martinprest/Psion2-Datapak-Rampak-reader-writer/Psion2_closed_thumb.jpg

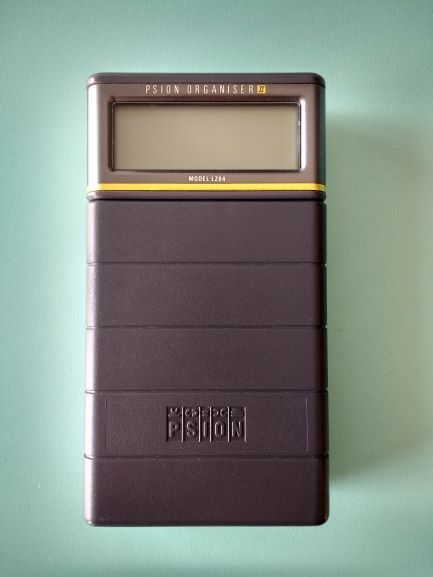
Psion2_closed_thumb.jpg
