martinprest/Psion2-Datapak-Rampak-reader-writer/Psion2_datapak_read_write_schematic.PNG

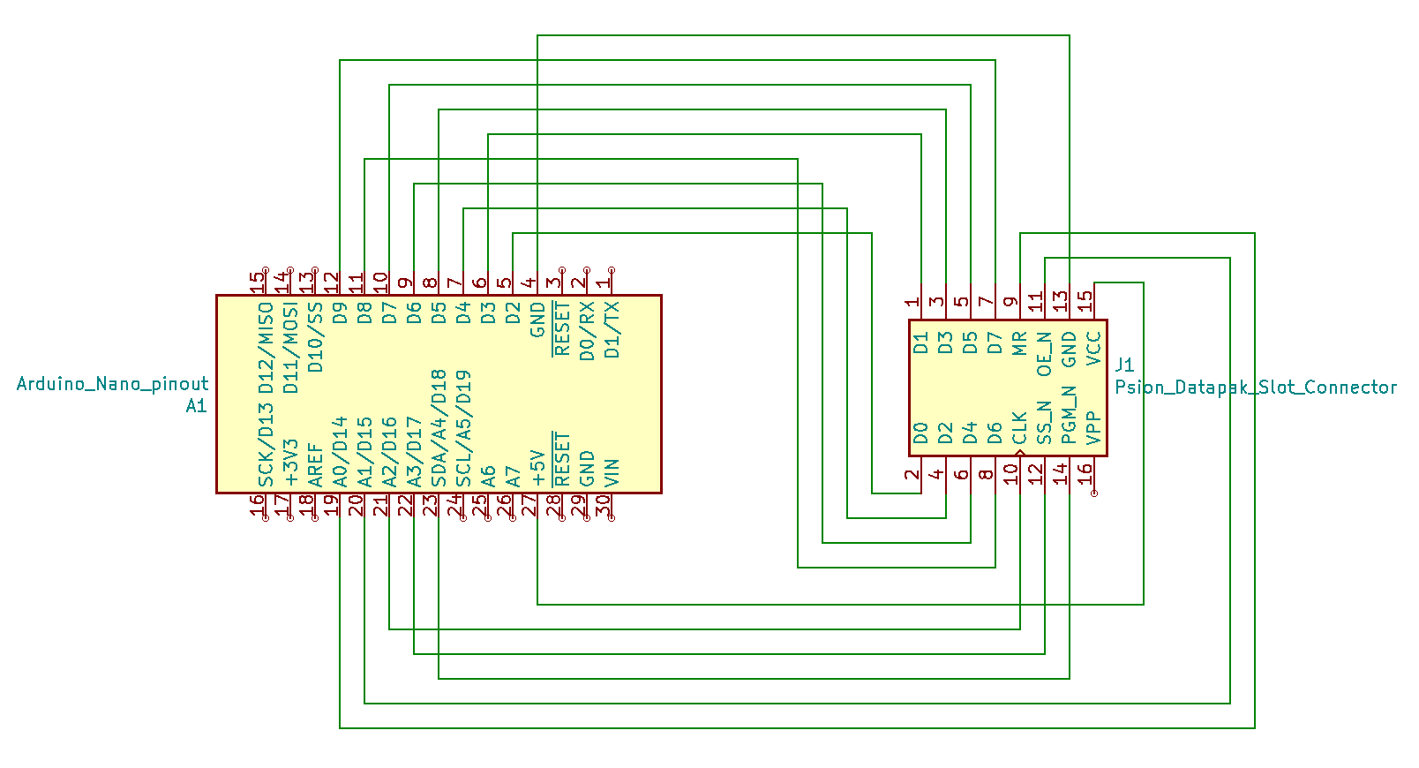
Psion2_datapak_read_write_schematic.PNG
