martinprest/Psion2-Datapak-Rampak-reader-writer/PC_Psion2_datapak_read_write_v1_3_1.py

0
# -*- coding: utf-8 -*-
"""
-------------------------------------------------------------------------
Datapak/Rampak Reader/Writer for Psion Organiser II
-------------------------------------------------------------------------
created by Martin Prest 2021

https://github.com/martinprest/Psion2-Datapak-Rampak-reader-writer

https://hackaday.io/project/176677-psion-ii-datapak-and-rampak-readerwriter

Uses linear or paged addressing, choose with paged_addr boolean variable below
packs that use segmented addressing are not supported
segmented addressing requires sending a segment address to the pack first

max read size is 64k bytes - could be increased, but packs larger than this generally use segmented addressing

v1.0 -  reads Datapaks and Rampaks, writes to Rampaks
works with: Arduino_Psion2_datapak_read-write_v1_0.ino on Arduino

v1.1 - added option for datapak write mode
works with: Arduino_Psion2_datapak_read-write_v1_1.ino on Arduino

v1.2 - Feb 2022 - added set_write_protect, update_checksum and fixedReadSize

v1.3 - Nov 2022 - added sizing and blank check using code from Matt Callow https://github.com/mattcallow/psion_pak_reader

v1.3.1 - Jan 2023 - bug fix for bootable pack types


"""

import keyboard as kb
import serial # uses pyserial
import time
import os

# set SerialPort and BaudRate values that work for your PC !! 

SerialPort = 'COM3' # Windows type port name, could be COM4 etc.
# SerialPort = '/dev/ttyUSB0' # Linux type port name, could be ttyUSB1 etc.

#BaudRate = 9600
# BaudRate = 19200
#BaudRate = 57600
BaudRate = 115200 # must match Arduino value

# numFFchk = 3 # must be same as Arduino program, to check for end of pack during read, if set_fixed_size = False

set_Rampak_ID = False # if false, leaves ID byte as it is in OPK file
# set_Rampak_ID = True # if true, modifies ID byte to set pack as a rampak
set_paged = False # if False, ID byte not modified
# set_paged = True # if True, modifies ID byte to set paged addressing
set_write_protect = False # if False, ID byte not modified
# set_write_protect = True # if True, modifies ID byte to set -write protect

update_checksum = False # if False uses checksum from OPK file
# update_checksum = True # if True, updates checksum to calculated one

read_fixed_size = False
# read_fixed_size = True
# read_pack_size = 0x7e9b
# read_pack_size = 0x0100

set_pack_size = False # if false, don't change pack size written to pack
# set_pack_size = True
#pack_size_out = 1 # 1*8 = 8 kB
#pack_size_out = 2 # 2*8 = 16 kB
pack_size_out = 4 # 4*8 = 32 kB

# infile = "rampak_colours.opk"
# infile = "comms42.opk"
infile = "testpak.opk"

print("Input filename:",infile)
f_size = os.path.getsize(infile)
print(f'(PC) File size is: {f_size} bytes, 0x{f_size:06x} bytes')

# outfile = "linear_datapak_blank_test_7e9b.opk"
outfile = "test.opk"
# outfile = "comms_linear_test.opk"

print("Output filename:",outfile)
f_out_open = False

def WritePak():
    print("(PC) Write")
    read_file = False
    f_in = open(infile,'rb')
    data = f_in.read(3) # Should be "OPK"
    header = data.decode()
    print(f'(PC) OPK header: "{header:s}"')
    if header != "OPK":
        print("Error! Not an OPK file!")
        return
    size_hh = ord(f_in.read(1))
    size_h = ord(f_in.read(1))
    size_l = ord(f_in.read(1))
    
    f_in_size = (size_hh << 16) + (size_h << 8) + size_l # shift size_h left 16 bits, size_h left 8 bits
    print(f'(PC) Pack image size: size_hh: 0x{size_hh:02x}, size_h: 0x{size_h:02x}, size_l: 0x{size_l:02x}, size: 0x{f_in_size:06x}')
        
    if f_in_size > 0xFFFF:
        print("(PC) File too big to write!")
        return
        
    size_h = (f_in_size & 0xFF00) >> 8 # high byte, shift right 8 bits, top byte (size_hh) removed, so max size is 64k!!
    size_l = f_in_size & 0xFF # lowest 8 bits, AND with 0xFF
    
    time.sleep(0.2) # 0.2 second delay for Arduino to send messages
    while ser.inWaiting(): # read & print lines from Arduino until none left
        line_in = ser.readline() 
        print("(PC) Empty buffer:", line_in.decode(), end='') # decode from bytes
    
    ser.write("XXWrite".encode()) # encode to bytes - tells Arduino that following bytes are for write to datapak
    ser.write(bytes([size_h])) # send high byte
    ser.write(bytes([size_l])) # send low byte
    
    print(f'(PC) size_h: 0x{size_h:02x}, size_l: 0x{size_l:02x}')
    
    read_file = True
    addr = 0
    data = []
    
    while read_file: # read file data to write to datapak
        dat_out = f_in.read(1) # read from file - initially must be first byte after header
        n = ord(dat_out)
        
        if addr <= 9: # first 10 bytes (0-9) stored for checksum
            
            # bytes to be modified:
            if addr == 0:
                if set_Rampak_ID == True:            
                    n = n & 0b11111101 # clear bit 1 - rampak
                if set_paged == True:
                    n = n | 0b100 # set bit 2 - Paged
                if set_write_protect == True:
                    n = n & 0b11110111 # clear bit 3 - write_protect
                print(f'0: ID byte: {n:02x}')
            if addr == 1:
                if set_pack_size == True:
                    print(f'1: Pack size was: {n*8:d} kB, now is: {pack_size_out*8:d} kB')
                    n = pack_size_out
                else:
                    print(f'1: Pack size is: {n*8:d} kB')
     
            # non-modified bytes: - now includes both types of header - untested !!
            
            if addr >= 2 and addr <= 7:
                if (data[0] & 0x10) != 0x10: # bootable pack
                    bootable_header = {2:{'txt':'code type',0:'software',1:'hardware'},
                                       3:{'txt':'id',0xc0:'RS232',0xbf:'bar code reader',0xbe:'swipe card reader',0x0a:'concise oxford spelling checker'},
                                       4:{'txt':'version (binary coded decimal: 0xnm for version n.m'},
                                       5:{'txt':'priority (can be same as id)'},
                                       6:{'txt':'boot code pack address (high)'},
                                       7:{'txt':'boot code pack address (low)'}}
                    if addr >= 2 and addr <= 3:
                        try:
                            print(f'{addr:d}: {bootable_header[addr]["txt"]}: {bootable_header[addr][n]}')
                        except:
                            print(f'{addr:d}: {bootable_header[addr]["txt"]}: unknown')
                    if addr >= 4:
                        print(f'{addr:d}: {bootable_header[addr]["txt"]}: 0x{n:02x}')
                    if addr == 7:
                        print(f'boot code pack address: 0x{data[6]:02x}{n:02x}')
                                   
                else: # standard pack
                    standard_header = {2:['Year at time of sizing was {:d}','n+1900'],
                                       3:['Month at time of sizing was {:d}','n+1'],
                                       4:['Day at time of sizing was {:d}','n+1'],
                                       5:['Hour at time of sizing was {:d}','n'],
                                       6:['Free Running Counter (High) at time of sizing was 0x{:02x}','n'],
                                       7:['Free Running Counter (Low) at time of sizing was 0x{:02x}','n']}
    
                    print(f'{addr:d}:',standard_header[addr][0].format(eval(standard_header[addr][1])))
                    
                    if addr == 6: FRH = n
                    if addr == 7:
                        FRL = n
                        FRCT = (FRH<<8) + FRL
                        print(f"Free Running Counter (Total) at time of sizing was {FRCT:d} 0x{FRCT:04x}")
                
            data.append(n) # store bytes for checksum, must include modified bytes
                  
            # checksum bytes: 
            if update_checksum == True: # update checksum if True
                if addr == 8:
                    print(f'Checksum:')
                    CHKSUM = (data[0]<<8) + data[1] + (data[2]<<8) + data[3] + (data[4]<<8) + data[5] + (data[6]<<8) + data[7]
                    chk_h = (CHKSUM & 0xFF00) >> 8 # mask for high byte
                    chk_l = CHKSUM & 0xFF # mask for low byte            
                    print(f'8: chk_h = 0x{chk_h:02x}')
                    print(f'9: chk_l = 0x{chk_l:02x}')
                    CHKSUM = CHKSUM & 0xFFFF # mask for 16 bits
                    print(f'Checksum (calculated) is: {CHKSUM:d} 0x{CHKSUM:04x}')
                    n = chk_h
                if addr == 9:
                    n = chk_l
            
        dat_out = bytes([n])
        ser.write(dat_out)
        t = time.time()
        while not (ser.inWaiting() > 0): # If no data, wait and check for timeout
            if time.time()-t > 1: # 1 s timeout
                read_file = False
                print("(PC) Timeout!")
        dat_in = ser.read(1) # read check byte back from Arduino
        n = ord(dat_in) # convert to number
        if 31 < n < 127: # if printable character
            n2 = n
        else: # else replace non-printable character
            n2 = 46 # character "."
        if addr >= 8:
            print(f'{addr:04x} {n:02x} {chr(n2):s}  ', end='')
        if dat_in != dat_out:
            print("(PC) Write data not verified by Arduino!")
            read_file = False
        addr += 1
        if addr >8 and addr % 0x08 == 0: # if remainder of addr div 8 is zero, newline
            print("") # newline
        if addr > f_in_size:
            read_file = False
            print("") # newline at end of file
    f_in.close()
    
def ReadPak():
    with open(outfile,'wb') as f_out: # open file for output
        f_out.write("OPK".encode())
        f_out.write(bytes(3)) # write 3 zero bytes for size, written later
        # write_file = True
        addr = 0
        read_size = [0,0,0];
        for i in range(3):
            n = ser.read(1) # read 3 bytes for pack size
            read_size[i] = ord(n) 
            # print(n, read_size)
        rd_size = (read_size[0]<<16) + (read_size[1]<<8) + (read_size[2])
        print(f'Read size: {rd_size:06x}')
        # while write_file == True:
        while True:
            # if ser.inWaiting():
            dat = ser.read(1) # read 1 value
            if dat == bytes(): # no byte from read!
                print('\n(PC) Timeout! No byte from Arduino')
                break
            ser.write(dat) # echo back to Arduino for verify
            # ser.write(bytes([0xFF])) // write a single byte of value 0xFF
            n = ord(dat) # convert char or b'\xff' hex byte to value
            if 31 < n < 127:
                n2 = n
            else:
                n2 = 46 # character "." for non-printable character
            print(f'{addr:04x} {n:02x} {chr(n2):s}  ', end='')
            f_out.write(dat) # write it to file
            if read_fixed_size == True:
                if addr >= read_pack_size or addr >= rd_size: # read_pack_size can't be bigger than pack
                    break
            elif addr >= rd_size:
                    break
            addr += 1
            if addr % 8 == 0: # if remainder of addr div 8 is zero, newline
                print("") # newline        
        f_out.seek(3) # move back to size bytes in PC outfile, byte 3: 0, 1, 2, 3
        addr_hh = (addr & 0xFF0000) >> 16 # high byte, mask & shift right 16 bits
        addr_h = (addr & 0xFF00) >> 8 # middle byte, mask & shift right 8 bits
        addr_l = addr & 0xFF # low byte
        f_out.write(bytes([addr_hh,addr_h,addr_l])) # write size, includes 0xFF bytes at end
        print("\n(PC) Datapak read to file has ended")
        

keys = ['e','r','w','0','1','2','3','t','m','l','i','d','b','?','x'] # allowed key list
loop = True
inp = ''
# try: # error trapping
with serial.Serial(SerialPort, BaudRate, timeout=0.5) as ser:
    print("Reading:",ser.name)
    while loop:
        time.sleep(0.001) # 1 ms delay to slow loop down
    
        if ser.inWaiting(): # message from Arduino waiting in serial input buffer
            msg = ser.readline()
            msg_d = msg.decode('utf-8','ignore') # decode from utf-8
    #        if ord(msg_d) == 10: print() # newline
            msg_s = "".join(i for i in msg_d if 32 <= ord(i) <= 126) # remove unwanted characters
    #        print(msg_s,end='') # message from Arduino, supress newline
            print(msg_s) # message from Arduino
            if msg_s == "XXRead": 
                ReadPak()
            if msg_s == "XXExit": 
                loop = False
                
        else: # no message from Arduino, so check for PC key press
                for key in keys:
                    if kb.is_pressed(key):
                        inp = key
                if kb.is_pressed('Enter'):
                    inp = '\n'
                if inp != '':
                    while kb.is_pressed(inp): # wait until key not pressed any more
                        pass # do nothing
#                        print(f'(PC) Key pressed: {inp:s} as bytes:',inp.encode()) # print keypress
                    ser.write(inp.encode()) # write inp key to serial
                    if inp == 'w':
                        WritePak()
                    inp = ''
# except:
    # print("\nError! Most likely a serial Error? Maybe Arduino not connected to serial port?")
        
