martinprest/Psion2-Datapak-Rampak-reader-writer/(commit log)

2021-04-12 Add files via upload
    improved clarity of pin connections
2022-11-20 bug fixes & bootable header
    [Arduino_Psion2_datapak_read_write_v1_3.ino, PC_Psion2_datapak_read_write_v1_3.py, Read_OPK_v4.py, ls_OPK.py]
2023-01-10 Create PC_Psion2_datapak_read_write_v1_3_1.py
    bug fix for bootable pack types
    [PC_Psion2_datapak_read_write_v1_3_1.py]
